spudfishScott/Apple-BIAS/README.md

# Apple-BIAS
BIAS SPI Master Card for Apple ][
