spudfishScott/Apple-BIAS/BIAS SPI Master v1.1.kicad_pcb

## KiCad design BIAS SPI Master v1.1.kicad_pcb (2020-08-07)

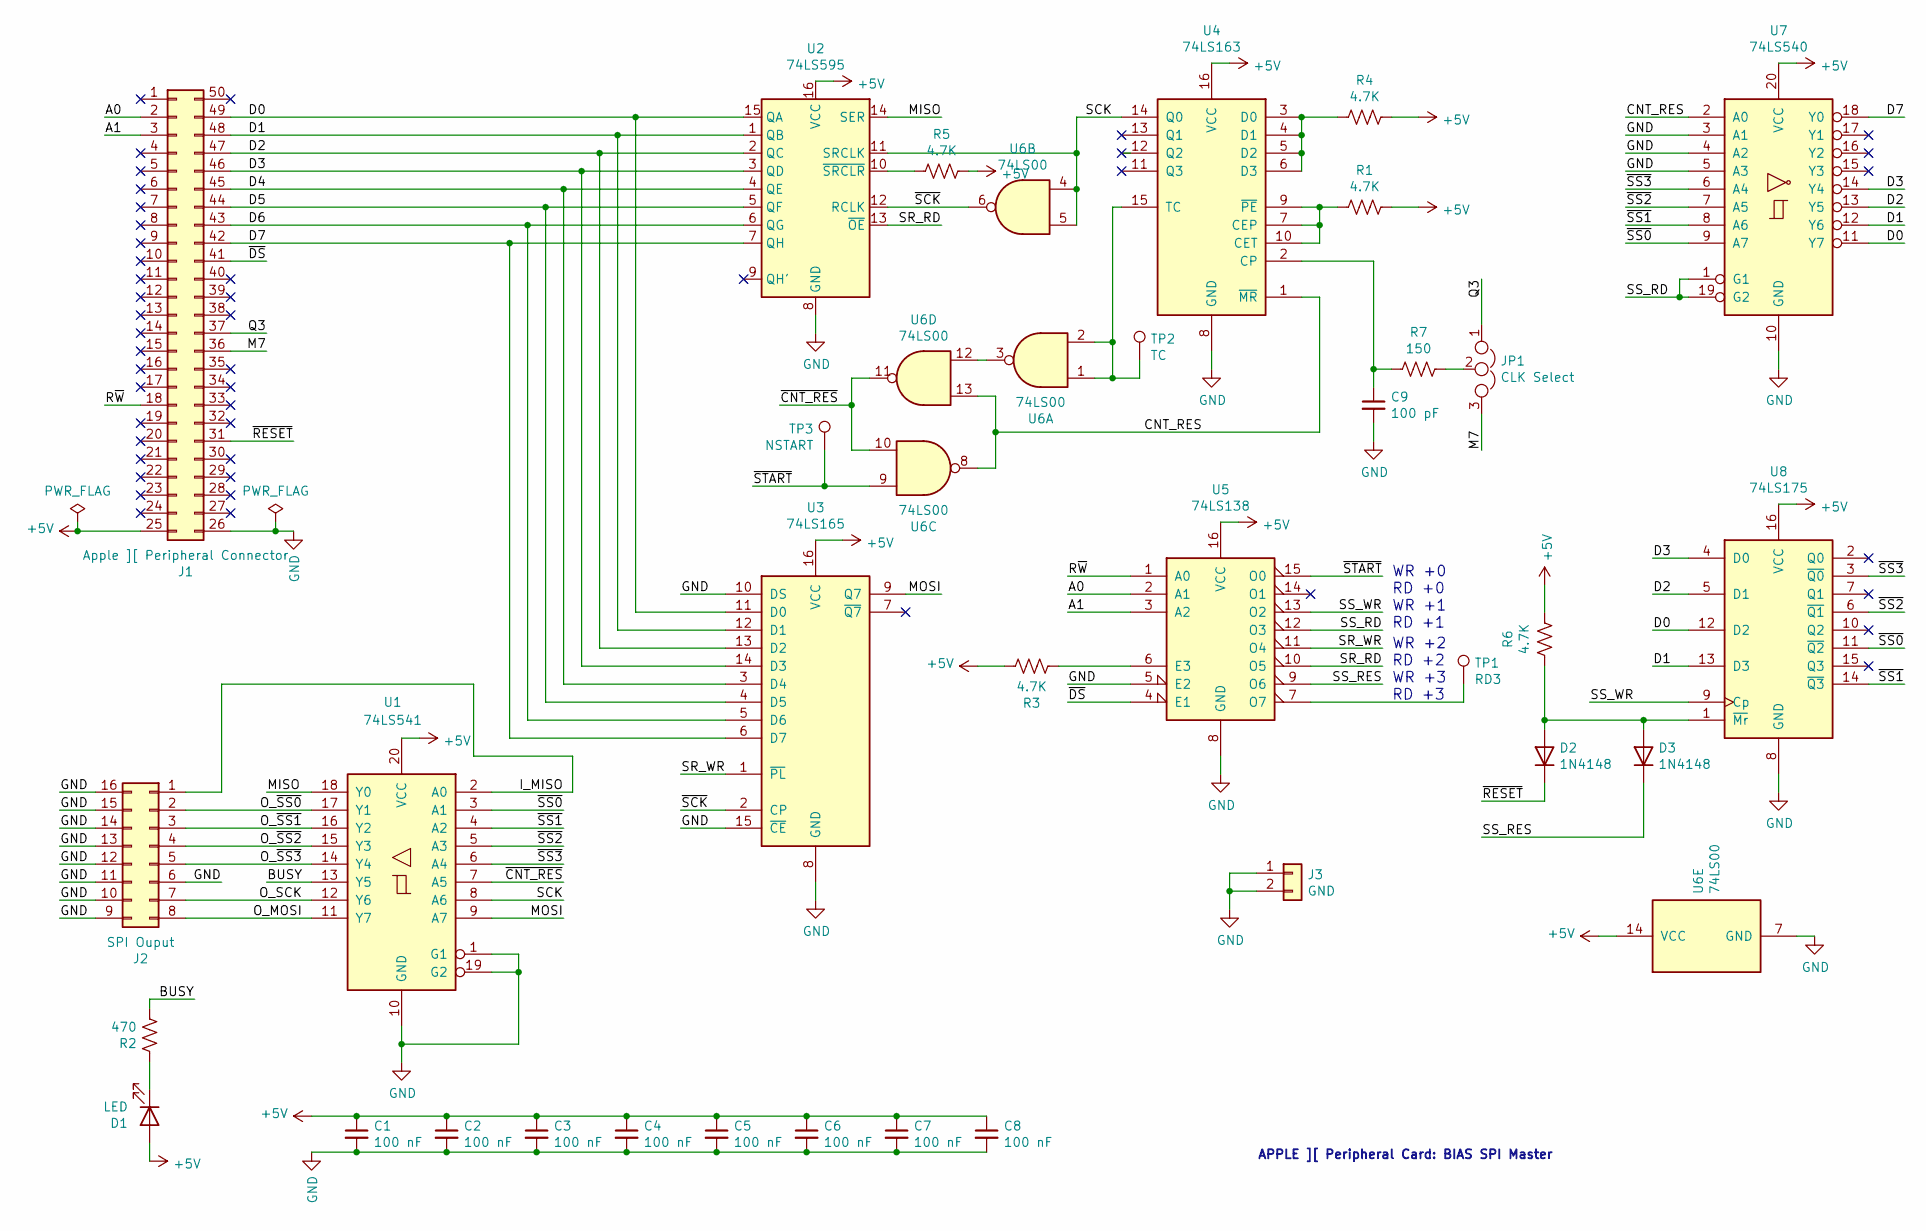
[picture p1: schematic BIAS SPI Master v1.1.sch]

Parts:
C1, C2, C3, C4, C5, C6, C7, C8: 100 nF; C_Axial_L3.8mm_D2.6mm_P7.50mm_Horizontal
C9: 100 pF; C_Rect_L7.0mm_W2.0mm_P5.00mm
D1: LED; LED_D3.0mm_Horizontal_O1.27mm_Z2.0mm
D2, D3: 1N4148; D_DO-35_SOD27_P7.62mm_Horizontal
J1: Apple ][ Peripheral Connector; Male_Card-Edge_50_pin__100_mil
J2: SPI Ouput; DIP-16_W7.62mm_Socket_LongPads
J3: GND; PinHeader_1x02_P2.54mm_Vertical
JP1: CLK Select; PinHeader_1x03_P2.54mm_Vertical
R1, R3, R4, R5, R6: 4.7K; R_Axial_DIN0207_L6.3mm_D2.5mm_P10.16mm_Horizontal
R2: 470; R_Axial_DIN0207_L6.3mm_D2.5mm_P10.16mm_Horizontal
R7: 150; R_Axial_DIN0207_L6.3mm_D2.5mm_P10.16mm_Horizontal
TP1: RD3; PinHeader_1x01_P2.54mm_Vertical
TP2: TC; PinHeader_1x01_P2.54mm_Vertical
TP3: NSTART; PinHeader_1x01_P2.54mm_Vertical
U1: 74LS541; DIP-20_W7.62mm_Socket_LongPads
U2: 74LS595; DIP-16_W7.62mm_Socket_LongPads
U3: 74LS165; DIP-16_W7.62mm_Socket_LongPads
U4: 74LS163; DIP-16_W7.62mm_Socket_LongPads
U5: 74LS138; DIP-16_W7.62mm_Socket_LongPads
U6: 74LS00; DIP-14_W7.62mm_Socket_LongPads
U7: 74LS540; DIP-20_W7.62mm_Socket_LongPads
U8: 74LS175; DIP-16_W7.62mm_Socket_LongPads

Connections:
+5V: C1.1, C2.1, C3.1, C4.1, C5.1, C6.1, C7.1, C8.1, D1.2 (A), J1.25, R1.1, R3.1, R4.1, R5.1, R6.1, U1.20 (VCC), U2.16 (VCC), U3.16 (VCC), U4.16 (VCC), U5.16 (VCC), U6.14 (VCC), U7.20 (VCC), U8.16 (VCC)
/A0: J1.2, U5.2 (A1)
/A1: J1.3, U5.3 (A2)
/BUSY: R2.2, U1.13 (Y5)
/CNT_RES: U4.1 (~MR), U6.8, U6.13, U7.2 (A0)
/D0: J1.49, U2.15 (QA), U3.11 (D0), U7.11 (Y7), U8.12 (D2)
/D1: J1.48, U2.1 (QB), U3.12 (D1), U7.12 (Y6), U8.13 (D3)
/D2: J1.47, U2.2 (QC), U3.13 (D2), U7.13 (Y5), U8.5 (D1)
/D3: J1.46, U2.3 (QD), U3.14 (D3), U7.14 (Y4), U8.4 (D0)
/D4: J1.45, U2.4 (QE), U3.3 (D4)
/D5: J1.44, U2.5 (QF), U3.4 (D5)
/D6: J1.43, U2.6 (QG), U3.5 (D6)
/D7: J1.42, U2.7 (QH), U3.6 (D7), U7.18 (Y0)
/I_MISO: J2.1, U1.2 (A0)
/M7: J1.36, JP1.3
/MISO: U1.18 (Y0), U2.14 (SER)
/MOSI: U1.9 (A7), U3.9 (Q7)
/O_MOSI: J2.8, U1.11 (Y7)
/O_SCK: J2.7, U1.12 (Y6)
/O_~SS0: J2.2, U1.17 (Y1)
/O_~SS1: J2.3, U1.16 (Y2)
/O_~SS2: J2.4, U1.15 (Y3)
/O_~SS3: J2.5, U1.14 (Y4)
/Q3: J1.37, JP1.1
/R~W: J1.18, U5.1 (A0)
/SCK: U1.8 (A6), U2.11 (SRCLK), U4.14 (Q0), U6.4, U6.5
/SR_RD: U2.13 (~OE), U5.10 (O5)
/SR_WR: U3.1 (~PL), U5.11 (O4)
/SS_RD: U5.12 (O3), U7.1 (G1), U7.19 (G2)
/SS_RES: D3.1 (K), U5.9 (O6)
/SS_WR: U5.13 (O2), U8.9 (Cp)
/~CNT_RES: U1.7 (A5), U6.10, U6.11
/~DS: J1.41, U5.4 (E1)
/~RESET: D2.1 (K), J1.31
/~SCK: U2.12 (RCLK), U3.2 (CP), U6.6
/~SS0: U1.3 (A1), U7.9 (A7), U8.11 (~Q2)
/~SS1: U1.4 (A2), U7.8 (A6), U8.14 (~Q3)
/~SS2: U1.5 (A3), U7.7 (A5), U8.6 (~Q1)
/~SS3: U1.6 (A4), U7.6 (A4), U8.3 (~Q0)
/~START: TP3.1, U5.15 (O0), U6.9
GND: C1.2, C2.2, C3.2, C4.2, C5.2, C6.2, C7.2, C8.2, C9.2, J1.26, J2.6, J2.9, J2.10, J2.11, J2.12, J2.13, J2.14, J2.15, J2.16, J3.1, J3.2, U1.1 (G1), U1.10 (GND), U1.19 (G2), U2.8 (GND), U3.8 (GND), U3.10 (DS), U3.15 (~CE), U4.8 (GND), U5.5 (E2), U5.8 (GND), U6.7 (GND), U7.3 (A1), U7.4 (A2), U7.5 (A3), U7.10 (GND), U8.8 (GND)
unnamed: C9.1, R7.2, U4.2 (CP)
unnamed: D1.1 (K), R2.1
unnamed: D2.2 (A), D3.2 (A), R6.2, U8.1 (~Mr)
unnamed: JP1.2, R7.1
unnamed: R1.2, U4.7 (CEP), U4.9 (~PE), U4.10 (CET)
unnamed: R3.2, U5.6 (E3)
unnamed: R4.2, U4.3 (D0), U4.4 (D1), U4.5 (D2), U4.6 (D3)
unnamed: R5.2, U2.10 (~SRCLR)
unnamed: TP1.1, U5.7 (O7)
unnamed: TP2.1, U4.15 (TC), U6.1, U6.2
unnamed: U6.3, U6.12

Notes on the sheet:
APPLE ][ Peripheral Card: BIAS SPI Master
WR +2 RD +2 WR +3 RD +3
WR +0 RD +0 WR +1 RD +1

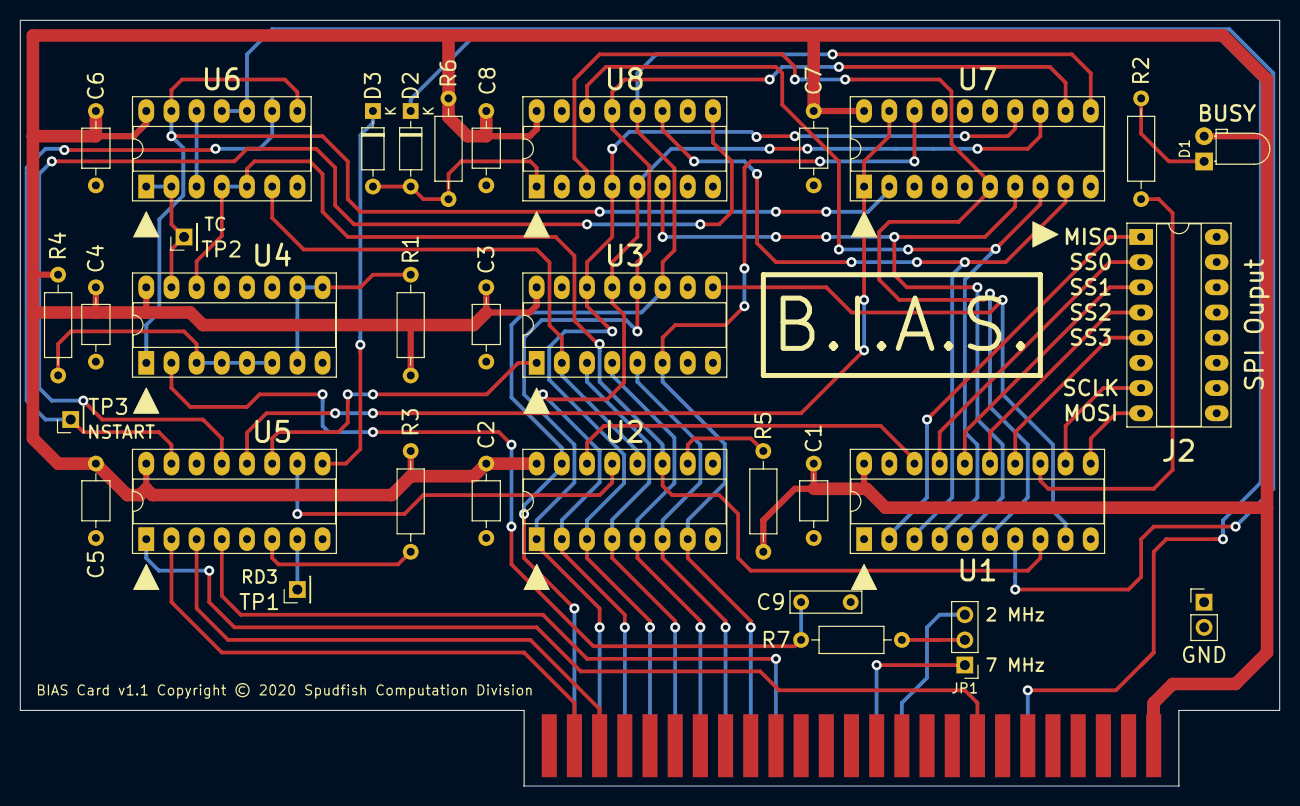
[picture p2: board BIAS SPI Master v1.1.kicad_pcb from above]

Board: 2 copper layers, 127.0 x 77.2 mm, 34 parts (0 on the bottom side), 52 nets.
