spudfishScott/Apple-BIAS/(commit log)

2020-01-13 Initial Upload
    [BIAS SPI Master v1.1.kicad_pcb, BIAS SPI Master v1.1.sch]
2020-03-19 fixed a couple of typos
    [BIAS SPI Master v1.1.kicad_pcb]
2020-08-06 Added low pass filter to clean up Apple ][ clock signal ringing
    [BIAS SPI Master v1.1.kicad_pcb, BIAS SPI Master v1.1.sch]
2020-08-07 Fixed RC filter schematic and PCB
    [BIAS SPI Master v1.1.kicad_pcb, BIAS SPI Master v1.1.sch]
