spudfishScott/Apple-BIAS/(notices)

Notices in the files:
BIAS SPI Master v1.1.kicad_pcb:
BIAS Card v1.1 Copyright © 2020 Spudfish Computation Division
